jbrenes/proyecto-umix/Codigo/www/header.JPG

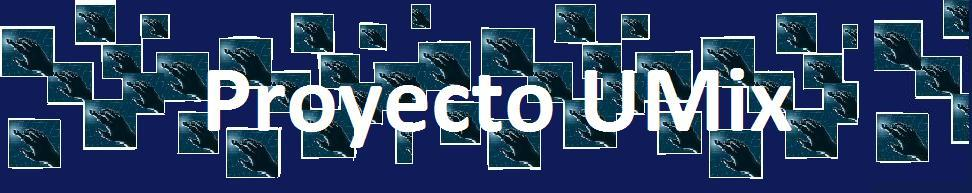
Codigo/www/header.JPG
