jbrenes/proyecto-umix/Otros/TvDTI/1.Caratula.pdf

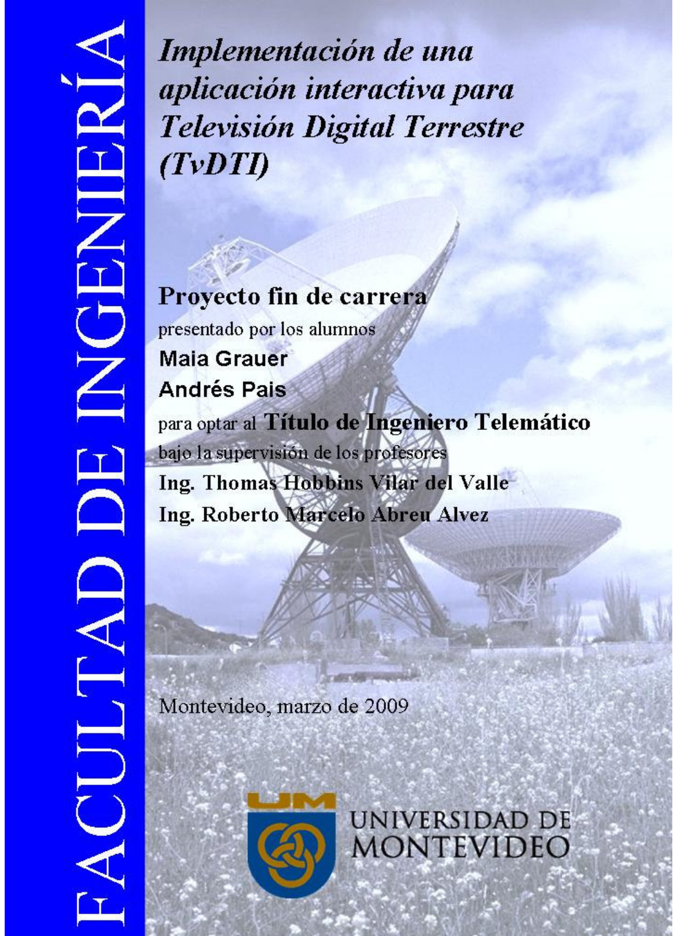
[picture p64: page 1]

@ | Proyecto de Fin de Carrera – generación 2004
| Ingeniería Telemática – UM Maia Grauer – Andrés Pais
- i -

# Universidad de Montevideo Facultad de Ingeniería

# TvDTI

# Implementación de una aplicación interactiva para Televisión Digital Terrestre

# Maia Grauer Andrés Pais

# Montevideo, marzo de 2009
