jbrenes/proyecto-umix/Documentos/Borradores/Diagrama de Flujo AtInt PIC.jpg

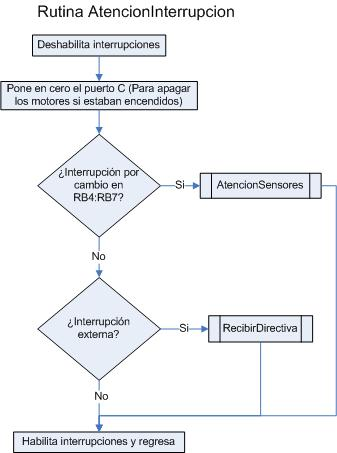
Documentos/Borradores/Diagrama de Flujo AtInt PIC.jpg
