jbrenes/proyecto-umix/Documentos/Borradores/Diagrama de Flujo AtSens PIC.jpg

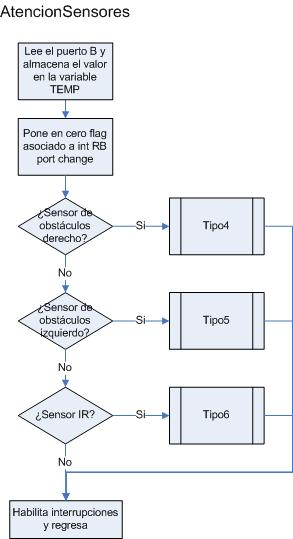
Documentos/Borradores/Diagrama de Flujo AtSens PIC.jpg
