jbrenes/proyecto-umix/Documentos/Borradores/Diagrama de Flujo Dir PIC.jpg

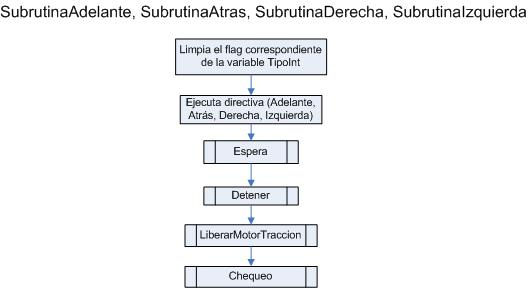
Documentos/Borradores/Diagrama de Flujo Dir PIC.jpg
