jbrenes/proyecto-umix/Documentos/Borradores/Diagrama de Flujo Main PIC.jpg

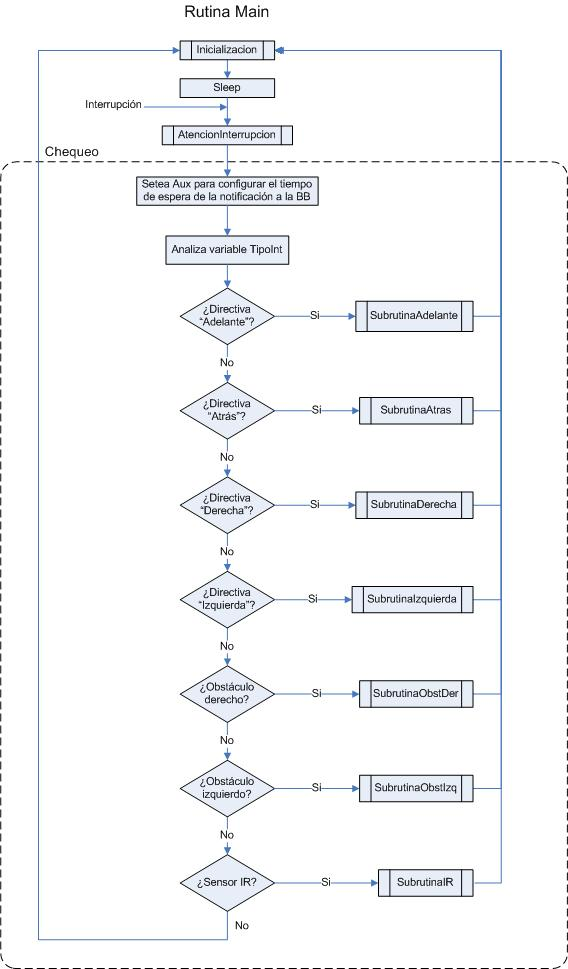
Documentos/Borradores/Diagrama de Flujo Main PIC.jpg
