jbrenes/proyecto-umix/Documentos/Borradores/Diagrama de Flujo RecDir PIC.jpg

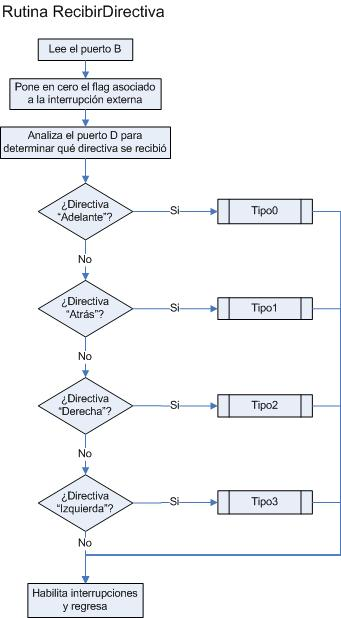
Documentos/Borradores/Diagrama de Flujo RecDir PIC.jpg
