jbrenes/proyecto-umix/Documentos/Borradores/Diagrama de Flujo SubrutObst PIC.jpg

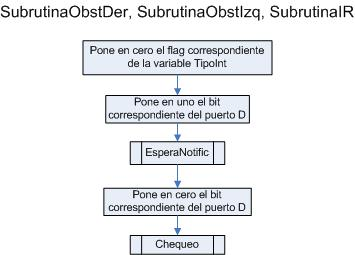
Documentos/Borradores/Diagrama de Flujo SubrutObst PIC.jpg
