jbrenes/proyecto-umix/Documentos/Borradores/Diagrama de Flujo Tipo4 y Tipo5 PIC.jpg

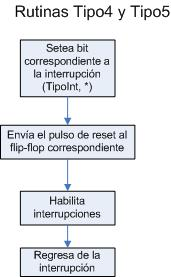
Documentos/Borradores/Diagrama de Flujo Tipo4 y Tipo5 PIC.jpg
