jbrenes/proyecto-umix/Documentos/Borradores/Diagrama de Flujo Tipo PIC.jpg

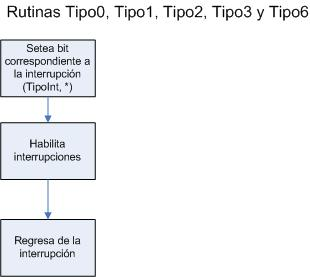
Documentos/Borradores/Diagrama de Flujo Tipo PIC.jpg
