jbrenes/proyecto-umix/(list of files, drawings)

Other design files:
Documentos/Borradores/Comunicación PIC-BB.DSN
Documentos/Borradores/Esquema emisor IR.DSN
Documentos/Borradores/Fuente de alimentación.DSN
Documentos/Borradores/Proyecto Sensor de Sonido.DSN
Documentos/Borradores/Proyecto sin Sensor de Sonido.DSN
Documentos/Borradores/Sensor IR.DSN
